paulc/CSPS-Controller/pcb/CSPS.kicad_pcb

## KiCad design pcb/CSPS.kicad_pcb (2026-10-05)

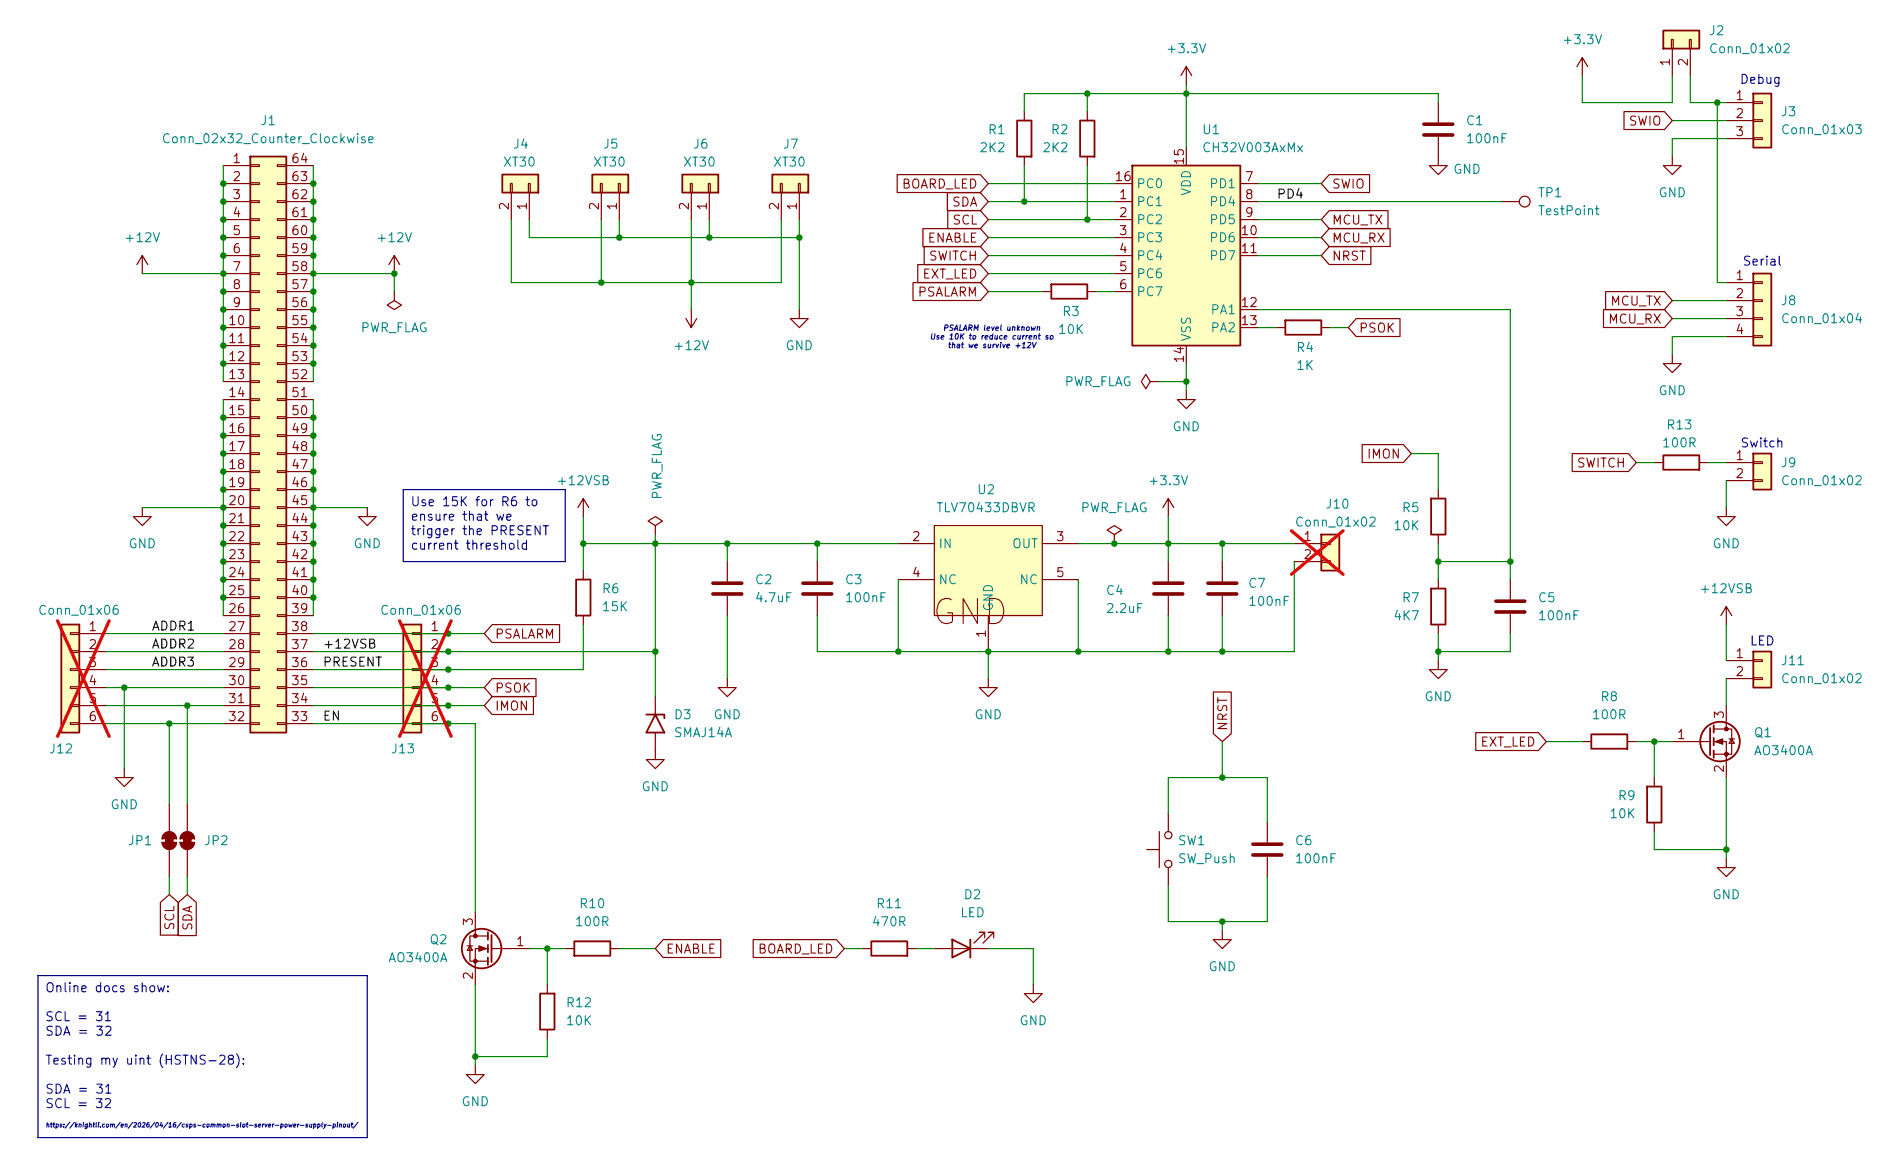
[picture p1: schematic CSPS.kicad_sch]

Parts:
C1, C3, C5, C6, C7: 100nF; C_1206_3216Metric_Pad1.33x1.80mm_HandSolder; LCSC C24497
C2: 4.7uF; C_1206_3216Metric_Pad1.33x1.80mm_HandSolder; LCSC C29823
C4: 2.2uF; C_1206_3216Metric_Pad1.33x1.80mm_HandSolder; LCSC C50254
D2: LED; LED_1206_3216Metric_Pad1.42x1.75mm_HandSolder; LCSC C3646937
D3: SMAJ14A; D_SMA; LCSC C908768
J1: Conn_02x32_Counter_Clockwise; 2x32 Edge Connector
J2: Conn_01x02; PinHeader_1x02_P2.54mm_Vertical
J3: Conn_01x03; JST_XH_B3B-XH-A_1x03_P2.50mm_Vertical
J4, J5, J6, J7: XT30; AMASS_XT30U-M_1x02_P5.0mm_Vertical
J8: Conn_01x04; JST_XH_B4B-XH-A_1x04_P2.50mm_Vertical
J9, J11: Conn_01x02; JST_XH_B2B-XH-A_1x02_P2.50mm_Vertical
J10: Conn_01x02; PinHeader_1x02_P2.54mm_Vertical; not fitted
J12, J13: Conn_01x06; PinHeader_1x06_P2.54mm_Vertical; not fitted
JP1, JP2: SolderJumper_2_Bridged; SolderJumper-2_P1.3mm_Bridged_RoundedPad1.0x1.5mm
Q1, Q2: AO3400A; SOT-23; LCSC C347475
R1, R2: 2K2; R_1206_3216Metric_Pad1.30x1.75mm_HandSolder; LCSC C17948
R3, R5, R9, R12: 10K; R_1206_3216Metric_Pad1.30x1.75mm_HandSolder; LCSC C17902
R4: 1K; R_1206_3216Metric_Pad1.30x1.75mm_HandSolder; LCSC C4410
R6: 15K; R_1206_3216Metric_Pad1.30x1.75mm_HandSolder; LCSC C25828
R7: 4K7; R_1206_3216Metric_Pad1.30x1.75mm_HandSolder; LCSC C17936
R8, R10, R13: 100R; R_1206_3216Metric_Pad1.30x1.75mm_HandSolder; LCSC C17901
R11: 470R; R_1206_3216Metric_Pad1.30x1.75mm_HandSolder; LCSC C4502
SW1: SW_Push; 3_4_2 SMD Micro Touch Switch Button; LCSC Part C843659
TP1: TestPoint; TestPoint_THTPad_1.0x1.0mm_Drill0.5mm
U1: CH32V003AxMx; STC_SOP-16_3.9x9.9mm_P1.27mm; LCSC C5346357
U2: TLV70433DBVR; SOT-23-5_L3.0-W1.7-P0.95-LS2.8-BR; MPN TLV70433DBVR; LCSC Part C94917

Connections:
+3.3V: C1.1, C4.1, C7.1, J2.1, J10.1, R1.1, R2.1, U1.15 (VDD), U2.3 (OUT)
+12V: J1.1, J1.2, J1.3, J1.4, J1.5, J1.6, J1.7, J1.8, J1.9, J1.10, J1.11, J1.12, J1.13, J1.52, J1.53, J1.54, J1.55, J1.56, J1.57, J1.58, J1.59, J1.60, J1.61, J1.62, J1.63, J1.64, J4.2, J5.2, J6.2, J7.2
+12VSB: C2.1, C3.1, D3.1 (A1), J1.37, J11.1, J13.2, R6.1, U2.2 (IN)
/ADDR1: J1.27, J12.1
/ADDR2: J1.28, J12.2
/ADDR3: J1.29, J12.3
/EN: J1.33, J13.6, Q2.3 (D)
/PD4: TP1.1 (1_1), U1.8 (PD4)
/PRESENT: J1.36, J13.3, R6.2
BOARD_LED: R11.1, U1.16 (PC0)
ENABLE: R10.1, U1.3 (PC3)
EXT_LED: R8.1, U1.5 (PC6)
GND: C1.2, C2.2, C3.2, C4.2, C5.2, C6.2, C7.2, D2.1 (K), D3.2 (A2), J1.14, J1.15, J1.16, J1.17, J1.18, J1.19, J1.20, J1.21, J1.22, J1.23, J1.24, J1.25, J1.26, J1.30, J1.39, J1.40, J1.41, J1.42, J1.43, J1.44, J1.45, J1.46, J1.47, J1.48, J1.49, J1.50, J1.51, J3.3, J4.1, J5.1, J6.1, J7.1, J8.4, J9.2, J10.2, J12.4, Q1.2 (S), Q2.2 (S), R7.1, R9.1, R12.1, SW1.1, U1.14 (VSS), U2.1 (GND), U2.4 (NC), U2.5 (NC)
IMON: J1.34, J13.5, R5.2
MCU_RX: J8.3, U1.10 (PD6)
MCU_TX: J8.2, U1.9 (PD5)
NRST: C6.1, SW1.2, U1.11 (PD7)
unnamed: D2.2 (A), R11.2
unnamed: J1.31, J12.5, JP2.2 (B)
unnamed: J1.32, J12.6, JP1.2 (B)
unnamed: J2.2, J3.1, J8.1
unnamed: J9.1, R13.2
unnamed: J11.2, Q1.3 (D)
unnamed: Q1.1 (G), R8.2, R9.2
unnamed: Q2.1 (G), R10.2, R12.2
unnamed: C5.1, R5.1, R7.2, U1.12 (PA1)
unnamed: R4.2, U1.13 (PA2)
unnamed: R3.1, U1.6 (PC7)
PSALARM: J1.38, J13.1, R3.2
PSOK: J1.35, J13.4, R4.1
SCL: JP1.1 (A), R2.2, U1.2 (PC2)
SDA: JP2.1 (A), R1.2, U1.1 (PC1)
SWIO: J3.2, U1.7 (PD1)
SWITCH: R13.1, U1.4 (PC4)

Notes on the sheet:
https://knightli.com/en/2026/04/16/csps-common-slot-server-power-supply-pinout/
LED
PSALARM level unknown Use 10K to reduce current so that we survive +12V
Debug
Serial
Switch
Online docs show: SCL = 31 SDA = 32 Testing my uint (HSTNS-28): SDA = 31 SCL = 32
Use 15K for R6 to ensure that we trigger the PRESENT current threshold

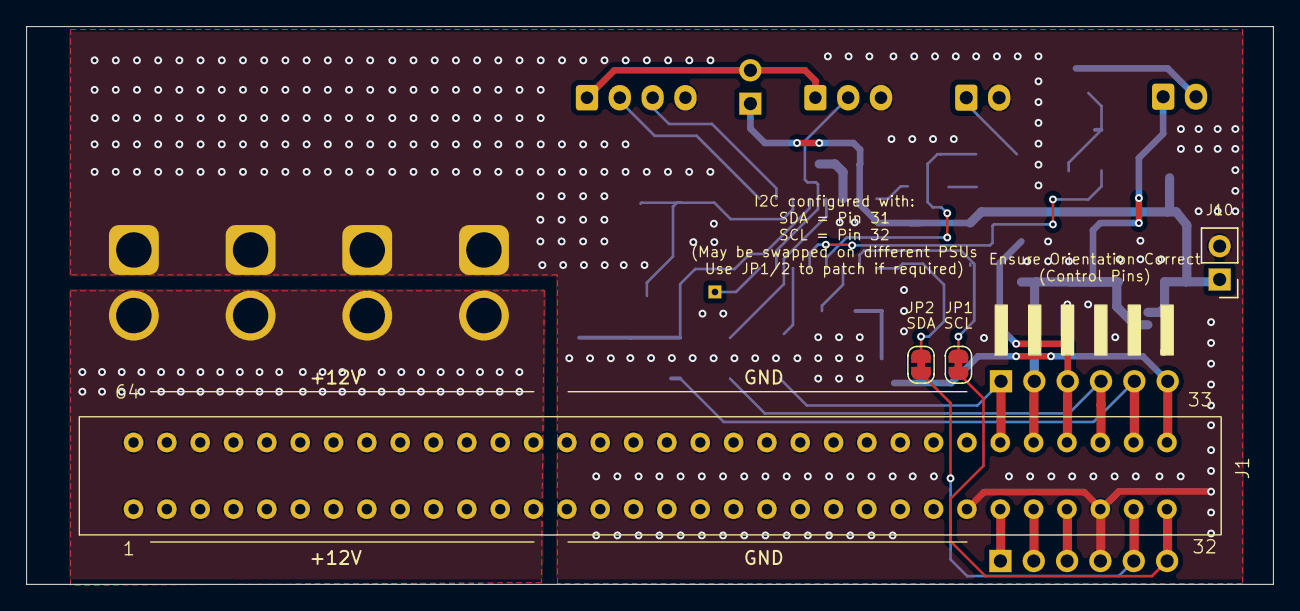
[picture p2: board CSPS.kicad_pcb from above]

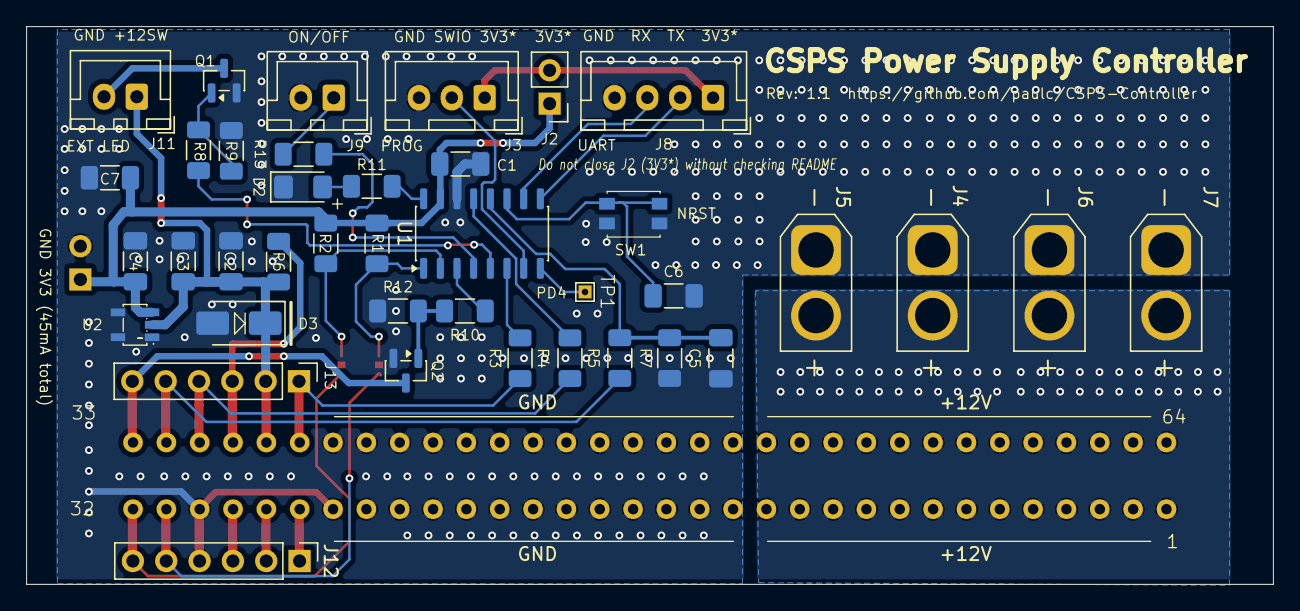
[picture p3: board CSPS.kicad_pcb from below]

Board: 2 copper layers, 95.0 x 42.5 mm, 43 parts (39 on the bottom side), 34 nets.
