paulc/CSPS-Controller/(commit log)

2026-09-15 Add CSPS PCB
    [BOM-CSPS.csv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]
2026-09-30 Fix connector footprint
    [CPL-CSPS.csv, CSPS-CuBottom.gbr, CSPS-CuTop.gbr, CSPS-EdgeCuts.gbr, CSPS-MaskBottom.gbr, CSPS-MaskTop.gbr, CSPS-NPTH.drl, CSPS-PTH.drl]
2026-10-05 PCB Update
    [BOM-CSPS.csv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]
